zachariahsharma/vent/production/Vent_V0.5.0_bom.csv

Designator | Footprint | Quantity | Value | LCSC Part #
C1, C2, C3 | 1206 | 3 | 22uF | CL31A226KAHNNNE
C5 | 0402 | 1 | .1 uF | C1005X7R1E104K050BB
C_{IN}2 | 0805 | 1 | 4.7uF | CL21A475KAQNNNE
C_{OUT}2 | 0805 | 1 | 10uF | TMK212BBJ106KGHT
D1 | LED_D3.0mm_Horizontal_O1.27mm_Z2.0mm | 1 | LED_GREEN | WP710A10GD
J2 | SolderWire-0.5sqmm_1x02_P4.6mm_D0.9mm_OD2.1mm | 1 | B2B-XH-A_LF__SN_ | B2B-XH-A(LF)(SN)
J3 | SolderWire-0.25sqmm_1x03_P4.2mm_D0.65mm_OD1.7mm | 1 | Conn_01x03_Pin
J4 | Tag-Connect_TC2030-IDC-NL_2x03_P1.27mm_Vertical | 1 | Conn_01x04_Socket
L1 | L_Murata_DFE201610P | 1 | 1uL | DFE201612E-1R0M=P2
L3 | L_Sunlord_SWPA3012S | 1 | 4.7uH | SWPA3012S4R7MT
R1 | 0603 | 1 | 732kR | RC0603FR-07732KL
R2, R3 | 0603 | 2 | 100kR | RC0603FR-07100KL
R5 | 0402 | 1 | 1MOhm | RC0402FR-071ML
R6 | 0402 | 1 | 330 KR | RC0402FR-07330KL
R7 | 0402 | 1 | 220R | RC0402FR-07220RL
R_{BOT}2 | 0603 | 1 | 309k | RC0603FR-07309KL
R_{TOP}2 | 0603 | 1 | 536k | RC0603FR-07536KL
SW1 | SW_PUSH_6mm_H5mm | 1 | SW_Push | PTS810SJK250SMTR LFS
U1 | ESP32-H2-MINI-1 | 1 | ESP32-H2-MINI-1 | ESP32-H2-MINI-1-H2S
U2 | SOT-563 | 1 | ~ | TPS61023DRLR
U4 | DFN-8-1EP_3x2mm_P0.5mm_EP1.75x1.45mm | 1 | MCP1640x-xMC | MCP1640T-I/MC
