zachariahsharma/vent/Vent.kicad_pcb

## KiCad design Vent.kicad_pcb (2026-10-26)

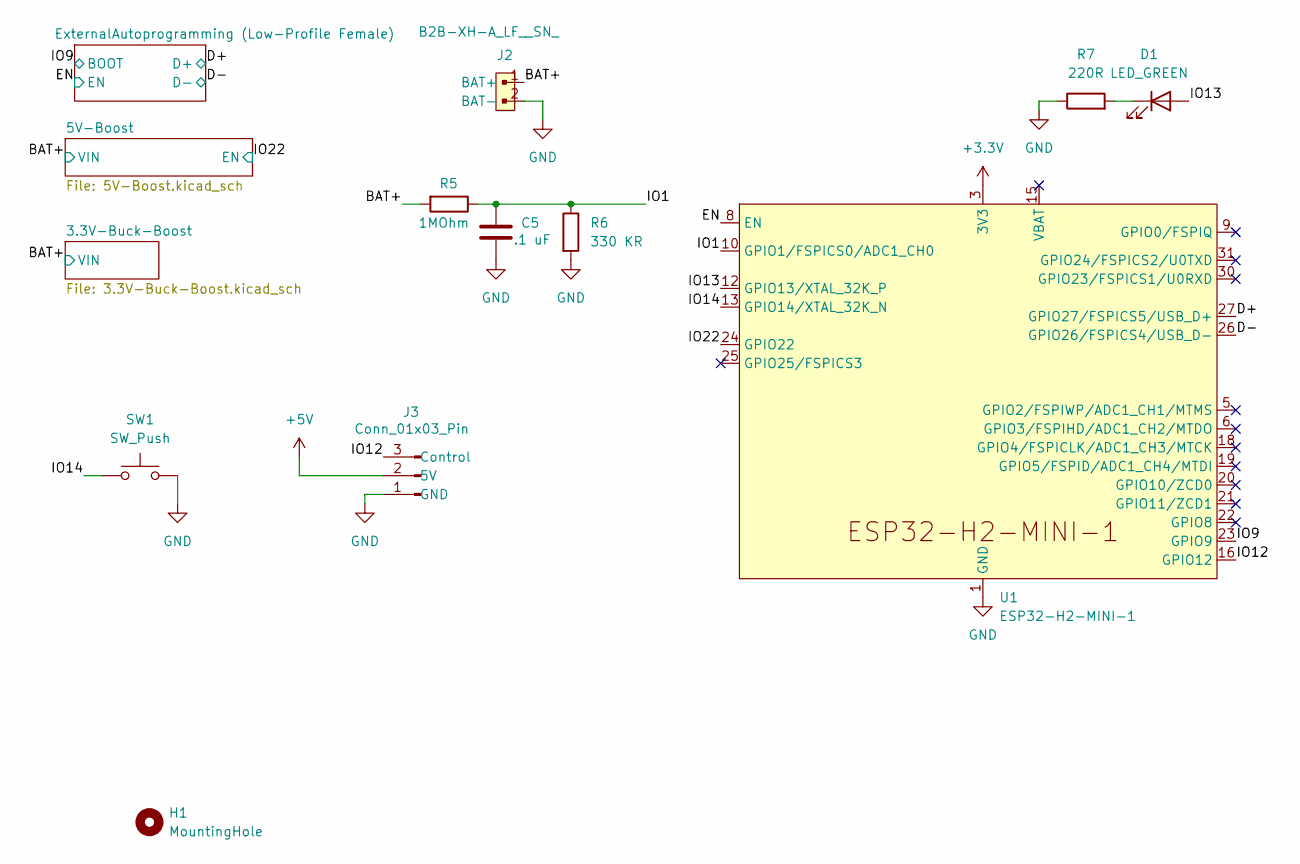
[picture p1: schematic Vent.kicad_sch]

Parts:
C5: .1 uF; C_0402_1005Metric; MPN C1005X7R1E104K050BB; Digi-Key_PN 445-7348-2-ND
D1: LED_GREEN; LED_D3.0mm_Horizontal_O1.27mm_Z2.0mm; MPN WP710A10GD; Digi-Key_PN 754-1603-ND
H1: MountingHole; MountingHole_2.2mm_M2
J2: B2B-XH-A_LF__SN_; SolderWire-0.5sqmm_1x02_P4.6mm_D0.9mm_OD2.1mm; MPN B2B-XH-A(LF)(SN); Digi-Key_PN 455-2247-ND
J3: Conn_01x03_Pin; SolderWire-0.25sqmm_1x03_P4.2mm_D0.65mm_OD1.7mm
R5: 1MOhm; R_0402_1005Metric; MPN RC0402FR-071ML; Digi-Key_PN 311-1.00MLRTR-ND
R6: 330 KR; R_0402_1005Metric; MPN RC0402FR-07330KL; Digi-Key_PN 311-330KLRTR-ND
R7: 220R; R_0402_1005Metric; MPN RC0402FR-07220RL; Digi-Key_PN 311-220LRTR-ND
SW1: SW_Push; SW_PUSH_6mm_H5mm; MPN PTS810SJK250SMTR LFS; Digi-Key_PN CKN10503TR-ND
U1: ESP32-H2-MINI-1; MPN ESP32-H2-MINI-1-H2S; Digi-Key_PN 1965-ESP32-H2-MINI-1-H2STR-ND

Connections:
+3.3V: U1.3 (3V3); also elsewhere on the board
+5V: J3.2 (5V); also elsewhere on the board
/BAT+: J2.1 (BAT+), R5.2; also elsewhere on the board
/D+: U1.27 (GPIO27/FSPICS5/USB_D+); also elsewhere on the board
/D-: U1.26 (GPIO26/FSPICS4/USB_D-); also elsewhere on the board
/EN: U1.8 (EN); also elsewhere on the board
/IO1: C5.1, R5.1, R6.1, U1.10 (GPIO1/FSPICS0/ADC1_CH0)
/IO9: U1.23 (GPIO9); also elsewhere on the board
/IO12: J3.3 (Control), U1.16 (GPIO12)
/IO13: D1.2 (A), U1.12 (GPIO13/XTAL_32K_P)
/IO14: SW1.1, U1.13 (GPIO14/XTAL_32K_N)
/IO22: U1.24 (GPIO22); also elsewhere on the board
GND: C5.2, J2.2 (BAT-), J3.1 (GND), R6.2, R7.1, SW1.2, U1.1 (GND), U1.2 (GND), U1.11 (GND), U1.14 (GND), U1.36 (GND), U1.37 (GND), U1.38 (GND), U1.39 (GND), U1.40 (GND), U1.41 (GND), U1.42 (GND), U1.43 (GND), U1.44 (GND), U1.45 (GND), U1.46 (GND), U1.47 (GND), U1.48 (GND), U1.49 (GND), U1.50 (GND), U1.51 (GND), U1.52 (GND), U1.53 (GND); also elsewhere on the board
unnamed: D1.1 (K), R7.2

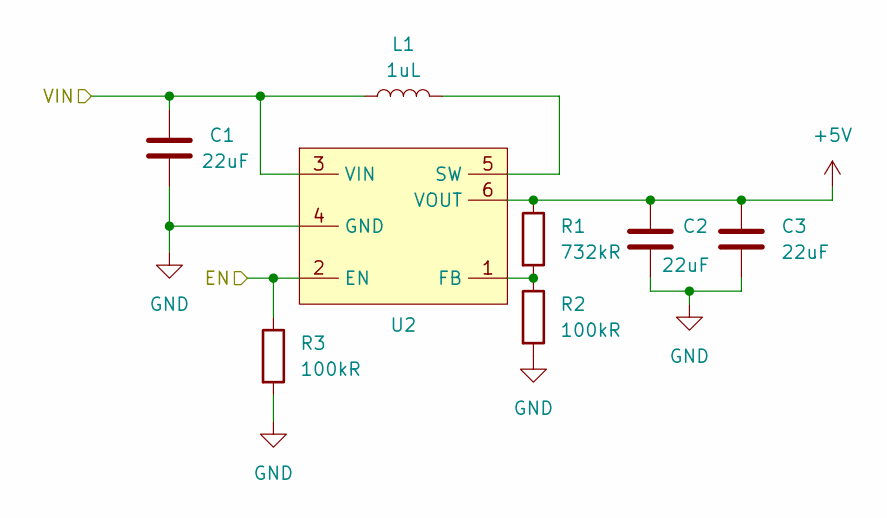
[picture p2: schematic 5V-Boost.kicad_sch, 5V Boost Voltage Regulator]

Parts:
C1, C2, C3: 22uF; C_1206_3216Metric; MPN CL31A226KAHNNNE; Digi-Key_PN 1276-3047-2-ND
L1: 1uL; L_Murata_DFE201610P; MPN DFE201612E-1R0M=P2; Digi-Key_PN 490-16593-2-ND
R1: 732kR; R_0603_1608Metric; MPN RC0603FR-07732KL; Digi-Key_PN 311-732KHRTR-ND
R2, R3: 100kR; R_0603_1608Metric; MPN RC0603FR-07100KL; Digi-Key_PN 311-100KHRTR-ND
U2: SOT-563; MPN TPS61023DRLR; Digi-Key_PN 296-TPS61023DRLRTR-ND

Connections:
+5V: C2.1, C3.1, R1.1, U2.6 (VOUT); also elsewhere on the board
/BAT+: C1.1, L1.1, U2.3 (VIN); also elsewhere on the board
/IO22: R3.1, U2.2 (EN); also elsewhere on the board
GND: C1.2, C2.2, C3.2, R2.2, R3.2, U2.4 (GND); also elsewhere on the board
unnamed: R1.2, R2.1, U2.1 (FB)
unnamed: L1.2, U2.5 (SW)

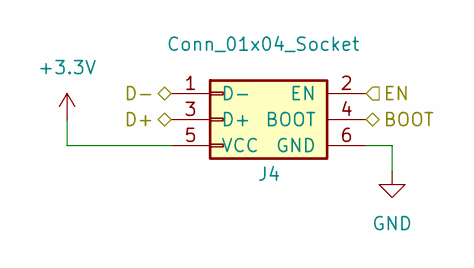
[picture p3: schematic ExternalAutoprogramming.kicad_sch, External Autoprogramming]

Parts:
J4: Conn_01x04_Socket; Tag-Connect_TC2030-IDC-NL_2x03_P1.27mm_Vertical

Connections:
+3.3V: J4.5 (VCC); also elsewhere on the board
/D+: J4.3 (D+); also elsewhere on the board
/D-: J4.1 (D-); also elsewhere on the board
/EN: J4.2 (EN); also elsewhere on the board
/IO9: J4.4 (BOOT); also elsewhere on the board
GND: J4.6 (GND); also elsewhere on the board

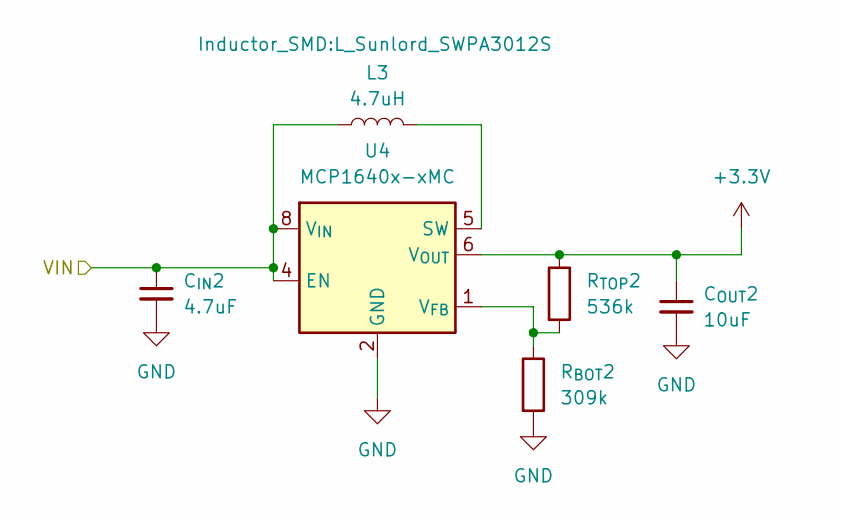
[picture p4: schematic 3.3V-Buck-Boost.kicad_sch, 3.3V Buck-Boost Voltage Regulator]

Parts:
C_{IN}2: 4.7uF; C_0805_2012Metric; MPN CL21A475KAQNNNE; Digi-Key_PN 1276-1244-2-ND
C_{OUT}2: 10uF; C_0805_2012Metric; MPN TMK212BBJ106KGHT; Digi-Key_PN 587-4334-2-ND
L3: 4.7uH; L_Sunlord_SWPA3012S; MPN SWPA3012S4R7MT; Digi-Key_PN 3442-SWPA3012S4R7MTTR-ND
R_{BOT}2: 309k; R_0603_1608Metric; MPN RC0603FR-07309KL; Digi-Key_PN 311-309KHRTR-ND
R_{TOP}2: 536k; R_0603_1608Metric; MPN RC0603FR-07536KL; Digi-Key_PN 311-536KHRTR-ND
U4: MCP1640x-xMC; DFN-8-1EP_3x2mm_P0.5mm_EP1.75x1.45mm; MPN MCP1640T-I/MC; Digi-Key_PN MCP1640T-I/MCTR-ND

Connections:
+3.3V: C_{OUT}2.1, R_{TOP}2.1, U4.6 (V_{OUT}), U4.7 (V_{OUT}); also elsewhere on the board
/BAT+: C_{IN}2.1, L3.1, U4.4 (EN), U4.8 (V_{IN}); also elsewhere on the board
GND: C_{IN}2.2, C_{OUT}2.2, R_{BOT}2.2, U4.2 (GND), U4.3 (GND), U4.9 (GND); also elsewhere on the board
unnamed: L3.2, U4.5 (SW)
unnamed: R_{BOT}2.1, R_{TOP}2.2, U4.1 (V_{FB})

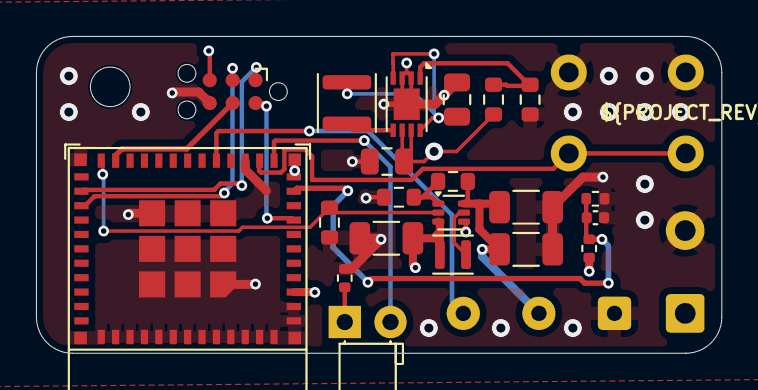
[picture p5: board Vent.kicad_pcb from above]

Board: 4 copper layers, 38.1 x 17.6 mm, 25 parts (1 on the bottom side), 18 nets.
